crmorano/UWMD-NCSU/README.md

UWMD-NCSU
=========

Underwater Metal Detector Design
