crmorano/UWMD-NCSU/SchematicAndPCB/Readme.txt

Group 6, UnderWater Metal Detector
Chris Morano
Dorian Perry
Bryson Pender

UnderWaterMetalDetector_v2.brd - EAGLE Board File
UnderWaterMetalDetector_v2.sch - EAGLE Schematic File
UnderWaterMetalDetector_v2.pdf - PDF of Eagle Schematic File
UWMD-BuildBOM.xlsx - Build BOM
UWMD-SeniorDesign-SeeedGerbers.zip - Gerber Files for SeeedStudio's Fusion PCB Service
