crmorano/UWMD-NCSU/SchematicAndPCB/UWMD-BuildBOM.xlsx

Sheet: Sheet1
Installed | Part | Value | Device | Package | Description | TP_SIGNAL_NAME
 | C1 | 0.1u | C-USC1206 | C1206 | CAPACITOR, American symbol
 | C6 | 0.1u | C-USC1206 | C1206 | CAPACITOR, American symbol
 | C7 | 0.1u | C-USC1206 | C1206 | CAPACITOR, American symbol
 | C8 | 0.1u | C-USC1206 | C1206 | CAPACITOR, American symbol
 | C11 | 0.1u | C-USC1206 | C1206 | CAPACITOR, American symbol
 | C12 | 47n | C-USC1206 | C1206 | CAPACITOR, American symbol
 | C13 | 0.1u | C-USC1206 | C1206 | CAPACITOR, American symbol
 | C14 | 0.1u | C-USC1206 | C1206 | CAPACITOR, American symbol
 | C15 | 47u | C-USC1206 | C1206 | CAPACITOR, American symbol | Ugh
 | C16 | 1u | C-USC1206 | C1206 | CAPACITOR, American symbol | Changed from 10u
 | COIL | CON-SIP2-0.1 | CON-SIP2-0.1 | CON-SIP2-0.1
 | D1 | 1N5819-T | 1N5819-T | DO41-7.6 | 1.0A SCHOTTKY BARRIER RECTIFIER | Already Have
 | D2 | 1N5819-T | 1N5819-T | DO41-7.6 | 1.0A SCHOTTKY BARRIER RECTIFIER | Already Have
 | D3 | 1N4004 | 1N4004 | DO41-10 | DIODE
 | D4 | 1N4004 | 1N4004 | DO41-10 | DIODE
 | D5 | P6KE68CA | DIODE-D-5 | D-5 | DIODE | Already Have
 | D6 | 1N4004 | 1N4004 | DO41-10 | DIODE
 | D7 | 1N4004 | 1N4004 | DO41-10 | DIODE
 | DOWN | CON-SIP2-0.1 | CON-SIP2-0.1 | CON-SIP2-0.1
 | DZ1 | LB10 | LB10 | LB10 | LED BLOCK | Already Have
X | IC2 | MCP604SL | MCP604SL | SO14 | Quad Op Amp 2.7V to 6.0V Single Supply CMOS
X | IC4 | ULN2003AD | ULN2003AD | SO16 | DRIVER ARRAY
 | J1 |  | MTA08-100 | 10X08MTA | AMP connector | SIP header
 | J2 |  | MTA08-100 | 10X08MTA | AMP connector | SIP header
 | J3 |  | MTA10-100 | 10X10MTA | AMP connector | SIP header
 | J4 |  | MTA06-100 | 10X06MTA | AMP connector | SIP header
 | JP2 | OUT | M02PTH | 1X02 | Header 2 | SIP header
 | JP9 | IN | M02PTH | 1X02 | Header 2 | SIP header
 | JP12 | LiPoIN | M02PTH | 1X02 | Header 2 | SIP header
 | JP13 | M01PTH | M01PTH | 1X01 | Header 1 | SIP header
 | JP14 | M01PTH | M01PTH | 1X01 | Header 1 | SIP header
 | L2 | 100m | L-US0204V | 0204V | INDUCTOR, American symbol
 | LED1 | Red | LED5MM | LED5MM | LED
 | LED2 | Red | LED5MM | LED5MM | LED
 | MODE | CON-SIP2-0.1 | CON-SIP2-0.1 | CON-SIP2-0.1
 | MOTOR | CON-SIP2-0.1 | CON-SIP2-0.1 | CON-SIP2-0.1
 | Q1 | STGP18N40LZ | STGP18N40LZ | TO-220-HORIZ |  | Already Have
 | Q2 | FET-2N7000 | FET-2N7000 | TO92
 | R1 | 1K | R-US_M1206 | M1206 | RESISTOR, American symbol
 | R2 | 10K | R-US_R1206 | R1206 | RESISTOR, American symbol
 | R3 | 10K | R-US_R1206 | R1206 | RESISTOR, American symbol
 | R4 | 5K1 | R-US_R1206 | R1206 | RESISTOR, American symbol
 | R5 | 330R | R-US_M1206 | M1206 | RESISTOR, American symbol
 | R6 | 330R | R-US_M1206 | M1206 | RESISTOR, American symbol
 | R7 | 330R | R-US_M1206 | M1206 | RESISTOR, American symbol
 | R8 | 330R | R-US_M1206 | M1206 | RESISTOR, American symbol
 | R9 | 330R | R-US_M1206 | M1206 | RESISTOR, American symbol
 | R10 | 330R | R-US_M1206 | M1206 | RESISTOR, American symbol
 | R11 | 330R | R-US_M1206 | M1206 | RESISTOR, American symbol
 | R12 | 330R | R-US_M1206 | M1206 | RESISTOR, American symbol
 | R13 | 330R | R-US_M1206 | M1206 | RESISTOR, American symbol
 | R14 | 330R | R-US_M1206 | M1206 | RESISTOR, American symbol
 | R15 | 330R | R-US_M1206 | M1206 | RESISTOR, American symbol
 | R16 | 330R | R-US_M1206 | M1206 | RESISTOR, American symbol
 | R17 | 1K | R-US_M1206 | M1206 | RESISTOR, American symbol
 | R18 | 1K | R-US_M1206 | M1206 | RESISTOR, American symbol
 | R19 | 100R | R-US_R1206 | R1206 | RESISTOR, American symbol
 | R20 | 100K | R-US_M1206 | M1206 | RESISTOR, American symbol
 | R21 | 10R | R-US_R2512 | R2512 | RESISTOR, American symbol
 | R22 | 100K | R-US_R1206 | R1206 | RESISTOR, American symbol
 | R23 | 100R | R-US_R1206 | R1206 | RESISTOR, American symbol
 | R31 | 4k7 | R-US_R1206 | R1206 | RESISTOR, American symbol
 | R32 | 1K | R-US_M1206 | M1206 | RESISTOR, American symbol
 | R33 | 90K9 | R-US_M1206 | M1206 | RESISTOR, American symbol
 | R34 | 22K0 | R-US_M1206 | M1206 | RESISTOR, American symbol
 | R35 | 10K | R-US_R1206 | R1206 | RESISTOR, American symbol
 | R36 | 10K | R-US_M1206 | M1206 | RESISTOR, American symbol
 | R37 | 10K | R-US_M1206 | M1206 | RESISTOR, American symbol
 | R38 | 11K8?? | R-US_M1206 | M1206 | RESISTOR, American symbol
 | R39 | 10K | R-US_M1206 | M1206 | RESISTOR, American symbol
 | R40 | 10K | R-US_M1206 | M1206 | RESISTOR, American symbol
 | R42 | 8R 1W | R-US_R2512 | R2512 | RESISTOR, American symbol
 | SW_DOWN | SW-SCHURTER-1301.9306 | SW-SCHURTER-1301.9306 | SW-SCHURTER-1301.9306 |  | Already Have
 | SW_MODE | SW-SCHURTER-1301.9306 | SW-SCHURTER-1301.9306 | SW-SCHURTER-1301.9306 |  | Already Have
 | SW_POW | SW-TL2201EEYA | SW-TL2201EEYA | SW-TL2201EEYA
 | SW_UP | SW-SCHURTER-1301.9306 | SW-SCHURTER-1301.9306 | SW-SCHURTER-1301.9306 |  | Already Have
 | TP1 | TPSQPAD1-13 | TPSQPAD1-13 | P1-13 | Test pad | No-Pop
 | TP2 | TPSQPAD1-13 | TPSQPAD1-13 | P1-13 | Test pad | No-Pop
 | TP3 | TPSQPAD1-13 | TPSQPAD1-13 | P1-13 | Test pad | No-Pop
 | TP4 | TPSQPAD1-13 | TPSQPAD1-13 | P1-13 | Test pad | No-Pop
 | TP5 | TPSQPAD1-13 | TPSQPAD1-13 | P1-13 | Test pad | No-Pop
 | TP6 | TPSQPAD1-13 | TPSQPAD1-13 | P1-13 | Test pad | No-Pop
 | TP7 | TPSQPAD1-13 | TPSQPAD1-13 | P1-13 | Test pad | No-Pop
 | TP8 | TPSQPAD1-13 | TPSQPAD1-13 | P1-13 | Test pad | No-Pop
 | TP9 | TPSQPAD1-13 | TPSQPAD1-13 | P1-13 | Test pad | No-Pop
 | TP10 | TPSQPAD1-13 | TPSQPAD1-13 | P1-13 | Test pad | No-Pop
 | U$3 | OSHW-LOGOS | OSHW-LOGOS | OSHW-LOGO-S | Open Source Hardware Logo This logo indicates the piece of hardware it is found on incorporates a OSHW license and/or adheres to the definition of open source hardware found here: http://freedomdefined.org/OSHW
 | U$4 | CREATIVE_COMMONS | CREATIVE_COMMONS | CREATIVE_COMMONS | Creative Commons License summary
 | UP | CON-SIP2-0.1 | CON-SIP2-0.1 | CON-SIP2-0.1

Sheet: Sheet2
Qty | Part | Value | Device | Package | Description | Notes | MFG | MFG Part Number | Digikey Part Number | Price at qty to build 5
7 | C1, C6, C7, C8, C11, C13, C14 | 0.1u | C-USC1206 | C1206 | CAP CER 0.1UF 50V 5% NP0 1206 |  | TDK | CGA5L2C0G1H104J160AA | 445-6984-1-ND | 0.67 | 4.69
1 | C12 | 47n | C-USC1206 | C1206 | CAP CER 0.047UF 50V 5% NP0 1206 |  | TDK | CGA5H2C0G1H473J115AA | 445-6982-1-ND | 0.6 | 0.6
1 | C15 | 47u | C-USC1206 | C1206 | CAP TANT 47UF 10V 20% 1206 |  | Rohm | TCTAL1A476M8R | 511-1500-1-ND | 1.19 | 1.19
1 | C16 | 1u | C-USC1206 | C1206 | CAP CER 1UF 100V 10% X7R 1206 |  | Taiyo Yuden | HMK316B7105KL-T | 587-1777-1-ND | 0.38 | 0.38
5 | COIL, UP, DOWN, MODE, MOTOR | CON-SIP2-0.1 | CON-SIP2-0.1 | CON-SIP2-0.1 | CONN TERM BLOCK 2.54MM 2POS PCB |  | On Shore | OSTVN02A150 | ED10561-ND | 0.51 | 2.55
2 | D1, D2, D7 | 1N5819-T | 1N5819-T | DO41-7.6 | 1.0A SCHOTTKY BARRIER RECTIFIER |  | Diodes Inc | 1N5819-T | 1N5819DICT-ND | 0.315 | 0.63
4 | D3, D4, D6 | 1N4004 | 1N4004 | DO41-10 | DIODE GEN PURPOSE 400V 1A DO41 |  | Diodes Inc | 1N4004-T | 1N4004DICT-ND | 0.12 | 0.48
1 | D5 | P6KE68CA | DIODE-D-5 | D-5 | TVS 68 VOLT 600 WATT BI-DIR | Install upright | Littelfuse | P6KE68CA | P6KE68CALFCT-ND | 0.49 | 0.49
1 | DZ1 | LB10 | LB10 | LB10 | LED BLOCK |  | Lite-On | LTA-1000HR | 160-1066-ND | 1.26 | 1.26
1 | IC2 | MCP604SL | MCP6004 | SO14 | Quad Op Amp 2.7V to 6.0V Single Supply CMOS |  | Microchip | MCP6004-I/SL | MCP6004-I/SL-ND | 0.53 | 0.53
1 | IC4 | ULN2003AD | ULN2003AD | SO16 | DRIVER ARRAY |  | TI | ULN2003AIDR | 296-15407-1-ND | 0.65 | 0.65
2 | J1, J2, J3, J4, JP13, JP14, JP2, JP9, JP12 |  | MTA08-100 | 10X08MTA | 0.1" Spacing Break Away Pins | JP12 No pop |  |  | SAM1112-20-ND | 2.302 | 4.604
1 | L2 | 100m | L-US0204V | 0204V | INDUCTOR, American symbol |  | EPCOS | B82144A2107J | 495-5616-1-ND | 1.08 | 1.08
2 | LED1, LED2 | Red | LED5MM | LED5MM | LED |  | Cree | C4SMF-RJS-CT0W0BB2 | C4SMF-RJS-CT0W0BB2CT-ND | 0.2 | 0.4
1 | Q1 | STGP18N40LZ | STGP18N40LZ | TO-220-HORIZ | IGBT 420V 30A 150W TO220 |  | ST Micro | STGP18N40LZ | 497-12597-5-ND | 1.55 | 1.55
1 | Q2 | FET-2N7000 | FET-2N7000 | TO92 | MOSFET N-CHAN 60V TO92-3 |  | Diodes Inc | ZVN4206AVSTZ | ZVN4206AVSCT-ND | 0.78 | 0.78
4 | R1, R17, R18, R32 | 1K | R-US_M1206 | M1206 | RES 1K OHM 1/4W 1% 1206 |  | Stackpole | RMCF1206FT1K00 | RMCF1206FT1K00CT-ND | 0.044 | 0.176
2 | R19, R23 | 100R | R-US_R1206 | R1206 | RES 100 OHM 1/4W 1% 1206 |  | Stackpole | RMCF1206FT100R | RMCF1206FT1K00CT-ND | 0.06 | 0.12
6 | R3, R35, R36, R37, R39, R40 | 10K | R-US_R1206 | R1206 | RES 10K OHM 1/4W 1% 1206 |  | Stackpole | RMCF1206FT10K0 | RMCF1206FT10K0CT-ND | 0.044 | 0.264
2 | R20, R22 | 100K | R-US_M1206 | M1206 | RES 100K OHM 1/4W 1% 1206 |  | Stackpole | RMCF1206FT100K | RMCF1206FT100KCT-ND | 0.06 | 0.12
1 | R21 | 10R | R-US_R2512 | R2512 | RES 10 OHM 1W 1% 2512 |  | Stackpole | RMCF2512JT10R0 | RMCF2512JT10R0CT-ND | 0.44 | 0.44
1 | R31 | 4k7 | R-US_R1206 | R1206 | RES 4K75 OHM 1/4W 1% 1206 |  | Stackpole | RMCF1206FT4K75 | RMCF1206FT4K75CT-ND | 0.06 | 0.06
1 | R33 | 90K9 | R-US_M1206 | M1206 | RES 90K9 OHM 1/4W 1% 1206 |  | Stackpole | RMCF1206FT90K9 | RMCF1206FT90K9CT-ND | 0.06 | 0.06
1 | R34 | 22K0 | R-US_M1206 | M1206 | RES 22K1 OHM 1/4W 1% 1206 |  | Stackpole | RMCF1206FT22K1 | RMCF1206FT22K1CT-ND | 0.06 | 0.06
1 | R38 | 10k5 | R-US_M1206 | M1206 | RES 10K7 OHM 1/4W 1% 1206 |  | Stackpole | RMCF1206FT10K5 | RMCF1206FT10K5CT-ND | 0.06 | 0.06
1 | R4 | 5K1 | R-US_R1206 | R1206 | RES 5K11 OHM 1/4W 1% 1206 |  | Stackpole | RMCF1206FT5K11 | RMCF1206FT5K11CT-ND | 0.06 | 0.06
1 | R42 | 7R5 1W | R-US_R2512 | R2512 | RES 7R50 OHM 1 1% 2512 |  | Stackpole | RMCF2512JT7R50 | RMCF2512JT7R50CT-ND | 0.44 | 0.44
14 | R2, R5, R6, R7, R8, R9, R10, R11, R12, R13, R14, R15, R16, R24 | 511R | R-US_M1206 | M1206 | RES 511 OHM 1/4W 1% 1206 |  | Stackpole | RMCF1206FT511R | RMCF1206FT511RCT-ND | 0.0242 | 0.3388
3 | SW_DOWN, SW_MODE, SW_UP |  | PUSHBUTTON | PUSHBUTTON |  |  | TE | FSM4JH | 450-1650-ND | 0.092 | 0.276
1 | SW_POW | SW-TL2201EEYA | SW-TL2201EEYA | SW-TL2201EEYA |  |  | E-Switch | TL2201EEYA | TL2201EEYA-ND | 0.66 | 0.66
1 |  |  | Motor |  |  | Not On Board | Parallax | 28822 | 28822-ND | 4.99 | 4.99
1 |  |  | Power |  | SFE LiPo Boost Charger Circuit | Not On Board | Sparkfun | PRT-11231 |  | 19.95 | 19.95
1 |  |  | Battery |  | 850mAh LiPo 3.7V Battery | Not On Board | Sparkfun | PRT-00341 |  | 8.95 | 8.95
1 |  |  | Arduino |  | Sparkfun Redboard Arduino Uno | Not On Board | Sparkfun | DEV-11575 |  | 24.95 | 24.95
1 |  |  | PCB |  | PCB Assembly Service | Not On Board | Fusion PCB |  |  | 6 | 6
1 |  |  | Wire |  |  | Not On Board | Radioshack | 278-1345
 |  |  |  |  |  |  |  |  |  |  | 89.8388
