crmorano/UWMD-NCSU/SchematicAndPCB/UnderWaterMetalDetector_v2.pdf

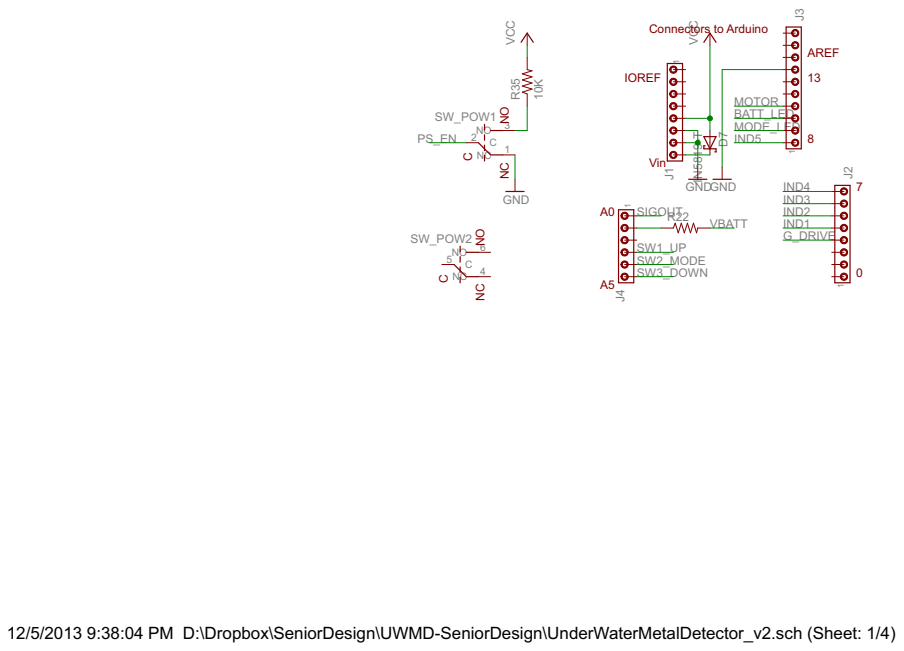
[picture p1: page 1]

12/5/2013 9:38:04 PM D:\Dropbox\SeniorDesign\UWMD-SeniorDesign\UnderWaterMetalDetector_v2.sch (Sheet: 1/4)

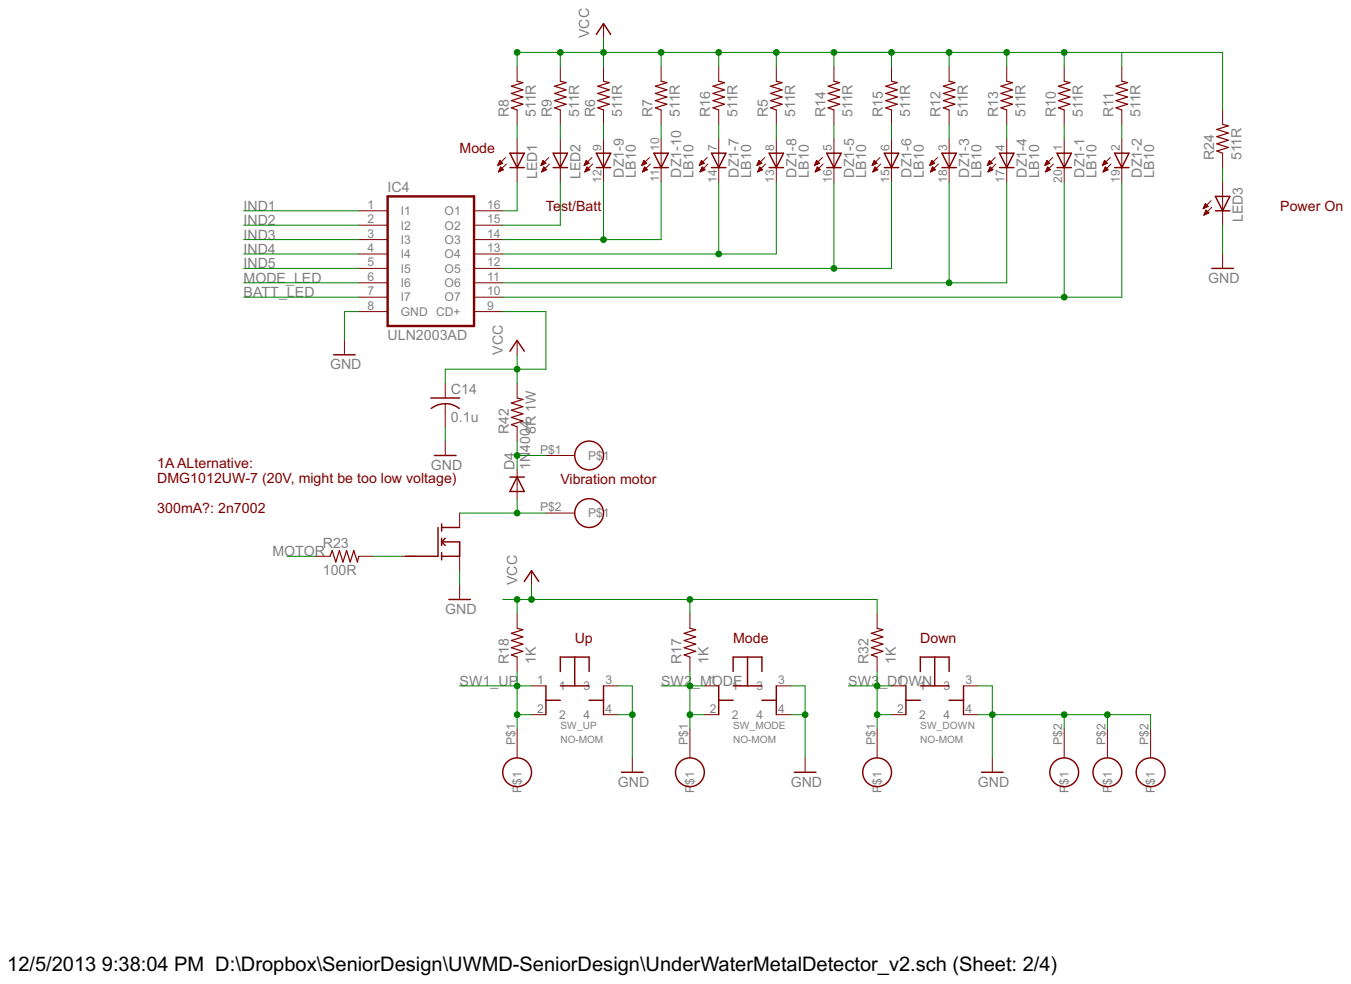
[picture p2: page 2]

1A ALternative: DMG1012UW-7 (20V, might be too low voltage)

12/5/2013 9:38:04 PM D:\Dropbox\SeniorDesign\UWMD-SeniorDesign\UnderWaterMetalDetector_v2.sch (Sheet: 2/4)

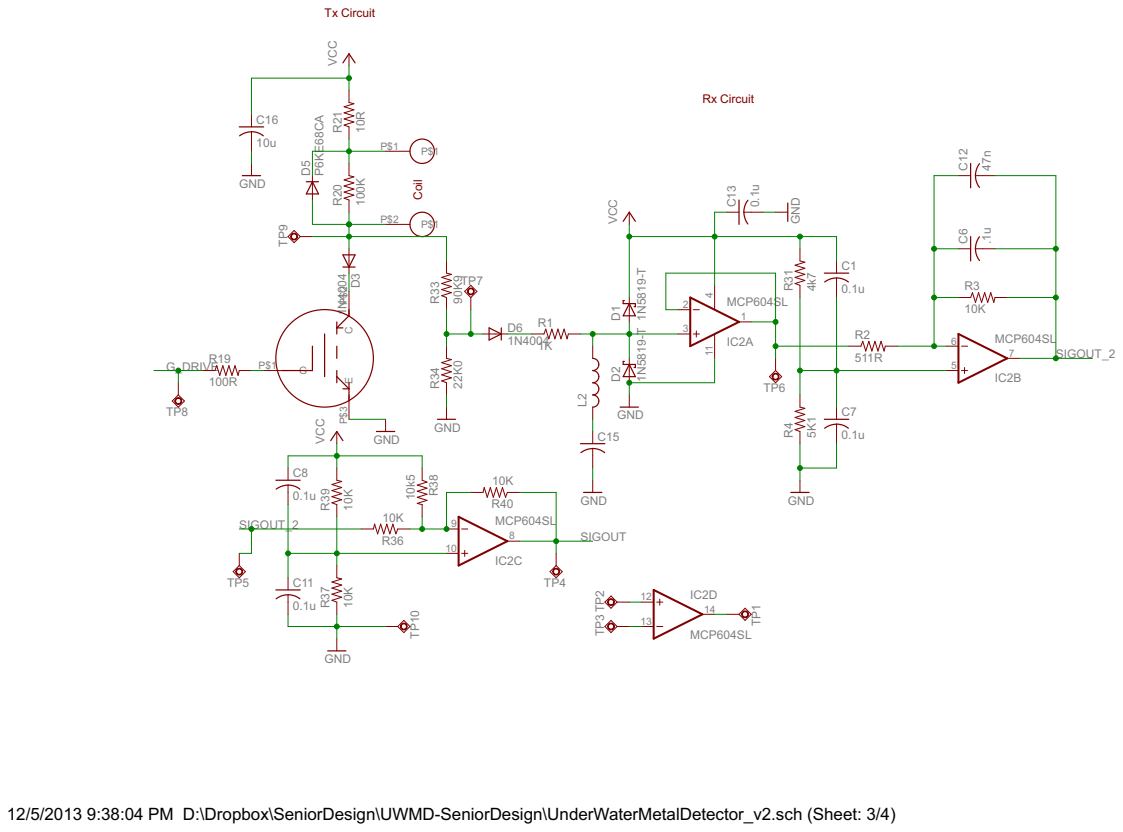
[picture p3: page 3]

12/5/2013 9:38:04 PM D:\Dropbox\SeniorDesign\UWMD-SeniorDesign\UnderWaterMetalDetector_v2.sch (Sheet: 3/4)

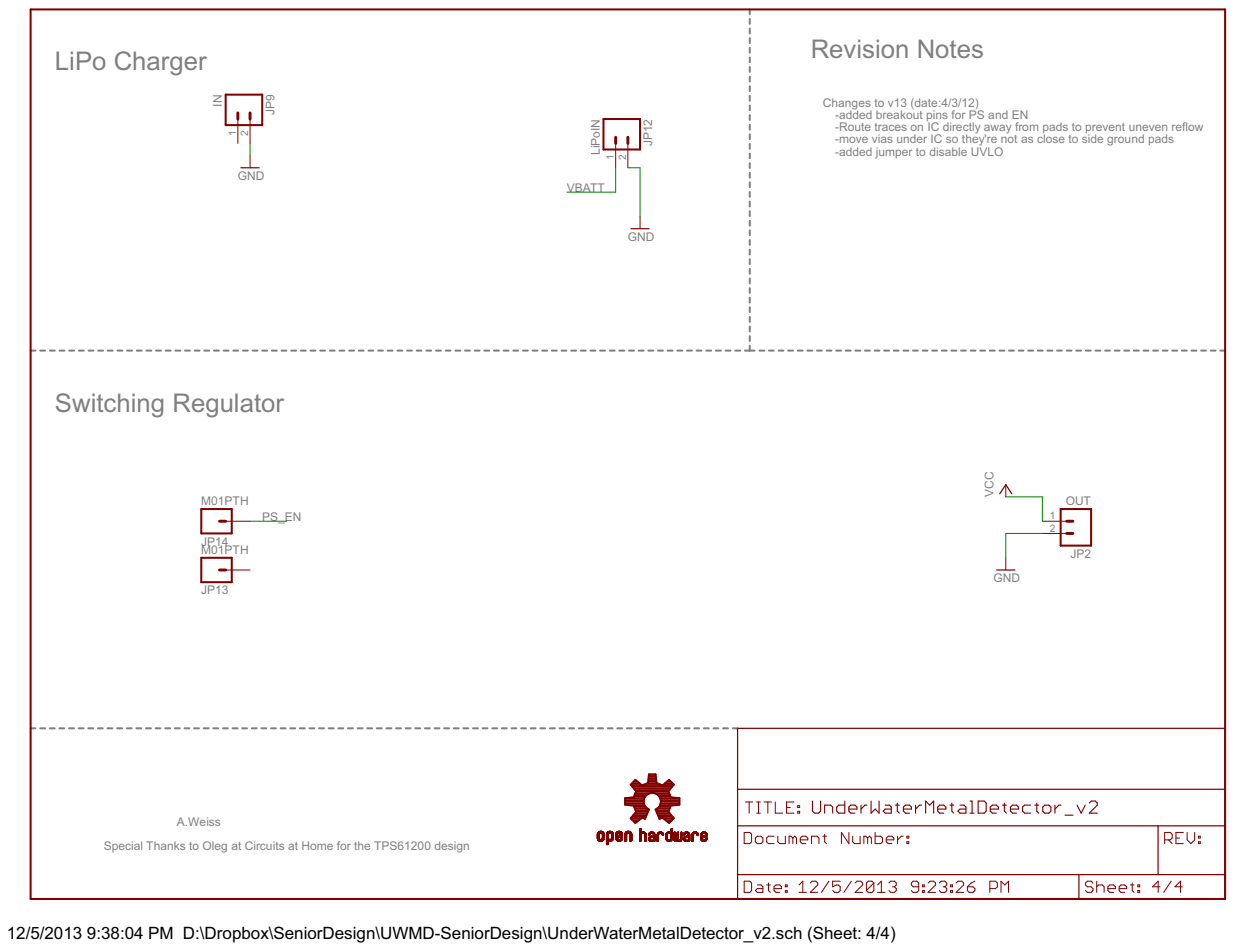
[picture p4: page 4]

Changes to v13 (date:4/3/12)
-added breakout pins for PS and EN
-Route traces on IC directly away from pads to prevent uneven reflow
-move vias under IC so they're not as close to side ground pads
-added jumper to disable UVLO

A.Weiss Special Thanks to Oleg at Circuits at Home for the TPS61200 design

12/5/2013 9:38:04 PM D:\Dropbox\SeniorDesign\UWMD-SeniorDesign\UnderWaterMetalDetector_v2.sch (Sheet: 4/4)
