crmorano/UWMD-NCSU/SchematicAndPCB/UnderWaterMetalDetector_v2.brd

## EAGLE design SchematicAndPCB/UnderWaterMetalDetector_v2.brd (2013-12-06)

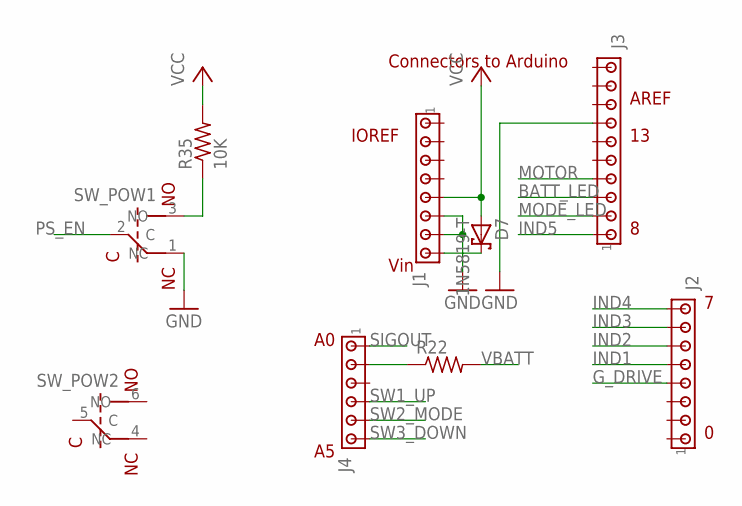
[picture p5: schematic UnderWaterMetalDetector_v2.sch, sheet 1]

Parts:
D7: 1N5819-T; DO41-7.6
J1, J2: MTA08-100; 10X08MTA
J3: MTA10-100; 10X10MTA
J4: MTA06-100; 10X06MTA
R22: R-US_R1206; R1206
R35: 10K; R1206
SW_POW: SW-TL2201EEYA

Connections:
BATT_LED: J3.3; also elsewhere on the board
GND: J1.6, J1.7, J3.7, SW_POW.1 (NC); also elsewhere on the board
G_DRIVE: J2.4; also elsewhere on the board
IND1: J2.5; also elsewhere on the board
IND2: J2.6; also elsewhere on the board
IND3: J2.7; also elsewhere on the board
IND4: J2.8; also elsewhere on the board
IND5: J3.1; also elsewhere on the board
MODE_LED: J3.2; also elsewhere on the board
MOTOR: J3.4; also elsewhere on the board
unnamed: J4.5 (2), R22.1
unnamed: D7.C, J1.8
unnamed: R35.1, SW_POW.3 (NO)
PS_EN: SW_POW.2 (C); also elsewhere on the board
SIGOUT: J4.6 (1); also elsewhere on the board
SW1_UP: J4.3 (4); also elsewhere on the board
SW2_MODE: J4.2 (5); also elsewhere on the board
SW3_DOWN: J4.1 (6); also elsewhere on the board
VBATT: R22.2; also elsewhere on the board
VCC: D7.A, J1.5, R35.2; also elsewhere on the board

Notes on the sheet:
Vin
IOREF
AREF
Connectors to Arduino

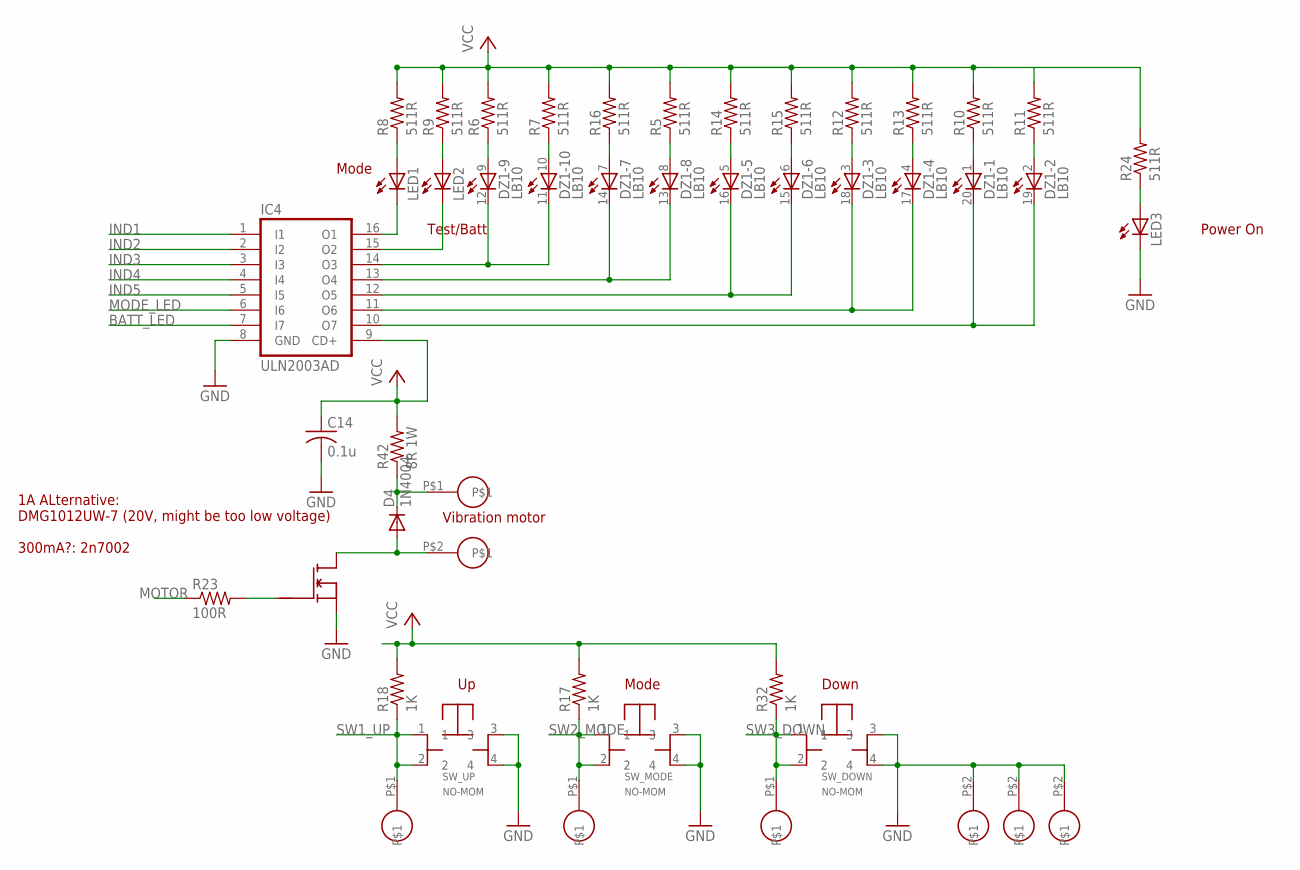
[picture p6: schematic UnderWaterMetalDetector_v2.sch, sheet 2, User Interface]

Parts:
C14: 0.1u; C1206
D4: 1N4004; DO41-10
DOWN: CON-SIP2-0.1
DZ1: LB10
IC4: ULN2003AD; SO16
LED1, LED2, LED3: LED5MM
MODE: CON-SIP2-0.1
MOTOR: CON-SIP2-0.1
Q2: FET-2N7000; TO92
R5, R6, R7, R8, R9, R10, R11, R12, R13, R14, R15, R16, R24: 511R; M1206
R17, R18, R32: 1K; M1206
R23: 100R; R1206
R42: 8R 1W; R2512
SW_DOWN: SW-SCHURTER-1301.9306
SW_MODE: SW-SCHURTER-1301.9306
SW_UP: SW-SCHURTER-1301.9306
UP: CON-SIP2-0.1

Connections:
BATT_LED: IC4.7 (I7); also elsewhere on the board
GND: C14.2, DOWN.P$2, IC4.8 (GND), LED3.K (C), MODE.P$2, Q2.1 (S), SW_DOWN.3, SW_DOWN.4, SW_MODE.3, SW_MODE.4, SW_UP.3, SW_UP.4, UP.P$2; also elsewhere on the board
IND1: IC4.1 (I1); also elsewhere on the board
IND2: IC4.2 (I2); also elsewhere on the board
IND3: IC4.3 (I3); also elsewhere on the board
IND4: IC4.4 (I4); also elsewhere on the board
IND5: IC4.5 (I5); also elsewhere on the board
MODE_LED: IC4.6 (I6); also elsewhere on the board
MOTOR: R23.1; also elsewhere on the board
unnamed: D4.C, MOTOR.P$1, R42.1
unnamed: DZ1.17 (C), DZ1.18 (C), IC4.11 (O6)
unnamed: Q2.2 (G), R23.2
unnamed: LED3.A, R24.1
unnamed: DZ1.19 (C), DZ1.20 (C), IC4.10 (O7)
unnamed: DZ1.15 (C), DZ1.16 (C), IC4.12 (O5)
unnamed: DZ1.13 (C), DZ1.14 (C), IC4.13 (O4)
unnamed: DZ1.11 (C), DZ1.12 (C), IC4.14 (O3)
unnamed: IC4.16 (O1), LED1.K (C)
unnamed: IC4.15 (O2), LED2.K (C)
unnamed: LED2.A, R9.1
unnamed: LED1.A, R8.1
unnamed: DZ1.10 (A), R7.1
unnamed: DZ1.9 (A), R6.1
unnamed: DZ1.8 (A), R5.1
unnamed: DZ1.1 (A), R10.1
unnamed: DZ1.2 (A), R11.1
unnamed: DZ1.3 (A), R12.1
unnamed: DZ1.4 (A), R13.1
unnamed: DZ1.5 (A), R14.1
unnamed: DZ1.6 (A), R15.1
unnamed: DZ1.7 (A), R16.1
unnamed: D4.A, MOTOR.P$2, Q2.3 (D)
SW1_UP: R18.1, SW_UP.1, SW_UP.2, UP.P$1; also elsewhere on the board
SW2_MODE: MODE.P$1, R17.1, SW_MODE.1, SW_MODE.2; also elsewhere on the board
SW3_DOWN: DOWN.P$1, R32.1, SW_DOWN.1, SW_DOWN.2; also elsewhere on the board
VCC: C14.1, IC4.9 (CD+), R5.2, R6.2, R7.2, R8.2, R9.2, R10.2, R11.2, R12.2, R13.2, R14.2, R15.2, R16.2, R17.2, R18.2, R24.2, R32.2, R42.2; also elsewhere on the board

Notes on the sheet:
Vibration motor
Mode
Test/Batt
Down
1A ALternative: DMG1012UW-7 (20V, might be too low voltage) 300mA?: 2n7002
Power On

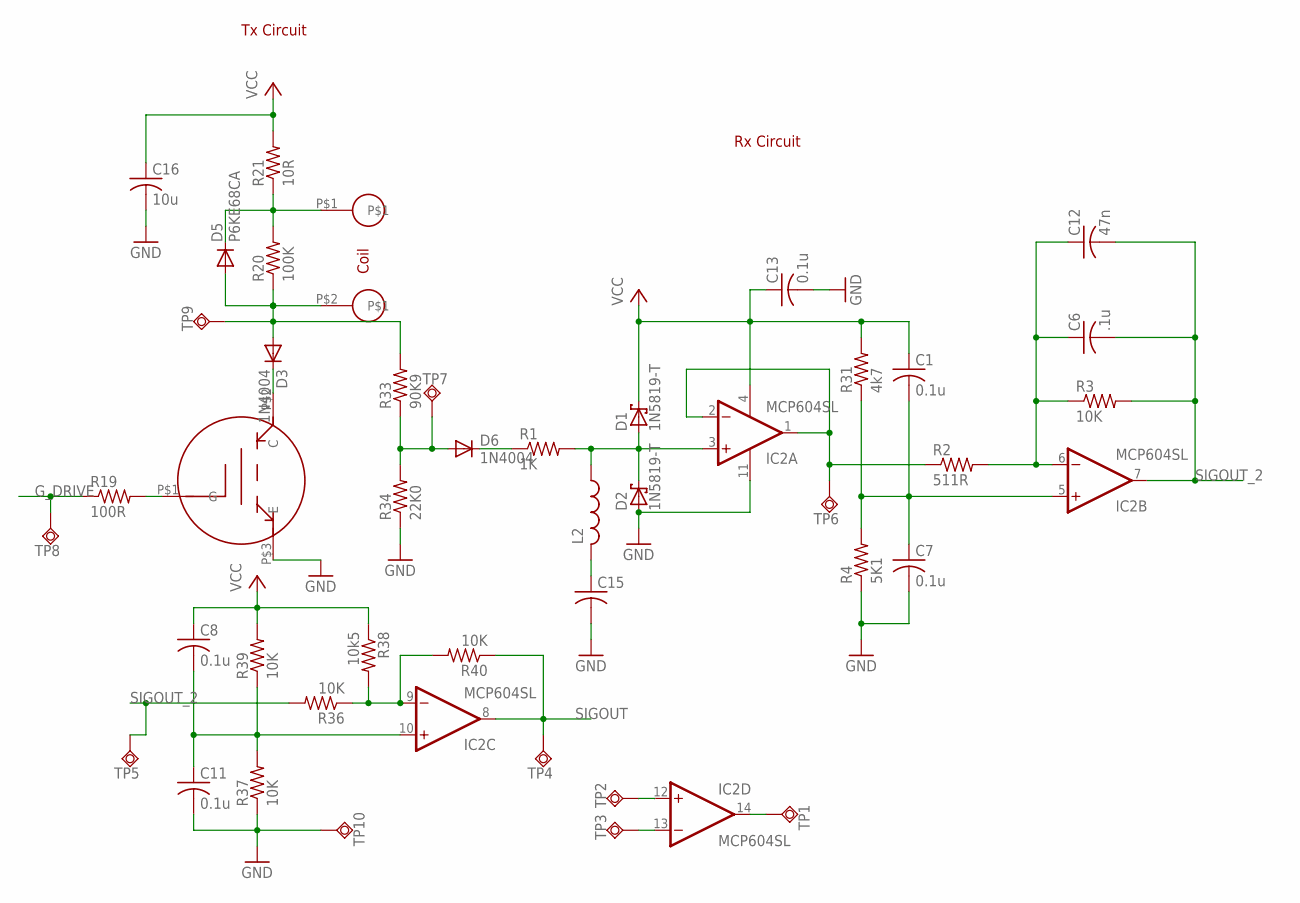
[picture p7: schematic UnderWaterMetalDetector_v2.sch, sheet 3]

Parts:
C1, C7, C8, C11, C13: 0.1u; C1206
C6: .1u; C1206
C12: 47n; C1206
C15: C-USC1206; C1206
C16: 10u; C1206
COIL: CON-SIP2-0.1
D1, D2: 1N5819-T; DO41-7.6
D3, D6: 1N4004; DO41-10
D5: P6KE68CA; D-5
IC2: MCP604SL; SO14
L2: L-US0204V; 0204V
Q1: STGP18N40LZ; TO-220-HORIZ
R1: 1K; M1206
R2: 511R; R1206
R3: 10K; R1206
R4: 5K1; R1206
R19: 100R; R1206
R20: 100K; M1206
R21: 10R; R2512
R31: 4k7; R1206
R33: 90K9; M1206
R34: 22K0; M1206
R36, R37, R39, R40: 10K; M1206
R38: 10k5; M1206
TP1, TP2, TP3, TP4, TP5, TP6, TP7, TP8, TP9, TP10: TPSQPAD1-13; P1-13

Connections:
GND: C7.2, C11.2, C13.2, C15.2, C16.2, D2.A, IC2.11 (V-), Q1.P$3 (E), R4.1, R34.1, R37.1, TP10.TP; also elsewhere on the board
G_DRIVE: R19.1, TP8.TP; also elsewhere on the board
unnamed: IC2.1 (OUT), IC2.2 (-IN), R2.1, TP6.TP
unnamed: D1.A, D2.C, IC2.3 (+IN), L2.1, R1.2
unnamed: D6.C, R1.1
unnamed: C1.2, C7.1, IC2.5 (+IN), R4.2, R31.1
unnamed: C8.2, C11.1, IC2.10 (+IN), R37.2, R39.1
unnamed: D6.A, R33.1, R34.2, TP7.TP
unnamed: C6.1, C12.1, IC2.6 (-IN), R2.2, R3.1
unnamed: IC2.9 (-IN), R36.1, R38.2, R40.2
unnamed: IC2.12 (+IN), TP2.TP
unnamed: IC2.13 (-IN), TP3.TP
unnamed: IC2.14 (OUT), TP1.TP
unnamed: C15.1, L2.2
unnamed: COIL.P$1, D5.C, R20.2, R21.1
unnamed: D3.C, Q1.P$2 (C)
unnamed: Q1.P$1 (G), R19.2
RXIN: COIL.P$2, D3.A, D5.A, R20.1, R33.2, TP9.TP
SIGOUT: IC2.8 (OUT), R40.1, TP4.TP; also elsewhere on the board
SIGOUT_2: C6.2, C12.2, IC2.7 (OUT), R3.2, R36.2, TP5.TP
VCC: C1.1, C8.1, C13.1, C16.1, D1.C, IC2.4 (V+), R21.2, R31.2, R38.1, R39.2; also elsewhere on the board

Notes on the sheet:
Coil
Tx Circuit
Rx Circuit

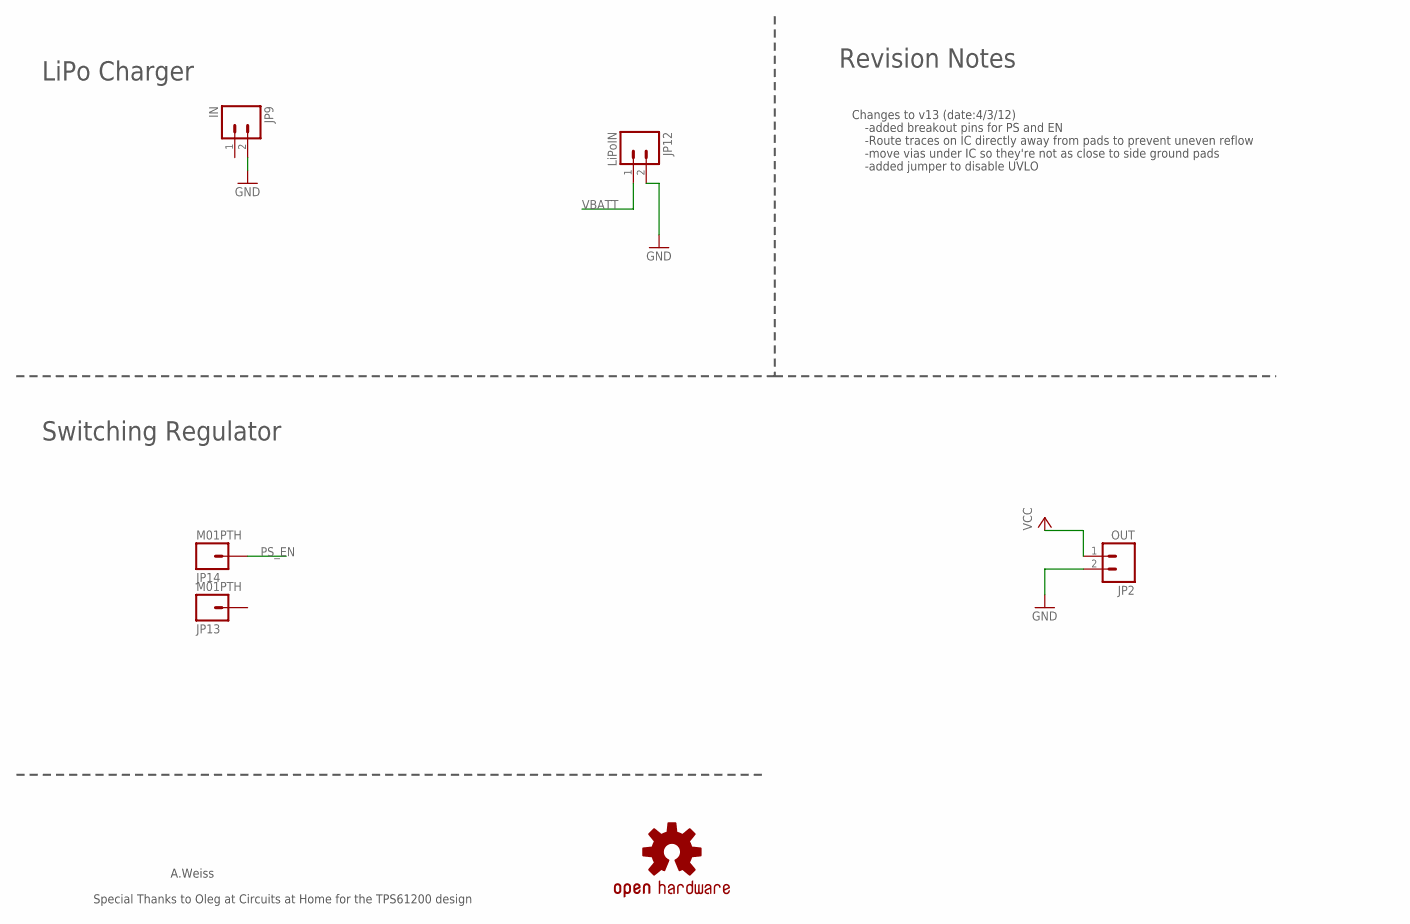
[picture p8: schematic UnderWaterMetalDetector_v2.sch, sheet 4]

Parts:
JP2: OUT; 1X02
JP9: IN; 1X02
JP12: LiPoIN; 1X02
JP13, JP14: M01PTH; 1X01
U$3: OSHW-LOGOS; OSHW-LOGO-S

Connections:
GND: JP2.2, JP9.2, JP12.2; also elsewhere on the board
PS_EN: JP14.1; also elsewhere on the board
VBATT: JP12.1; also elsewhere on the board
VCC: JP2.1; also elsewhere on the board

Notes on the sheet:
Changes to v13 (date:4/3/12)
-added breakout pins for PS and EN
-Route traces on IC directly away from pads to prevent uneven reflow
-move vias under IC so they're not as close to side ground pads
-added jumper to disable UVLO
A.Weiss
Special Thanks to Oleg at Circuits at Home for the TPS61200 design
LiPo Charger
Switching Regulator
Revision Notes

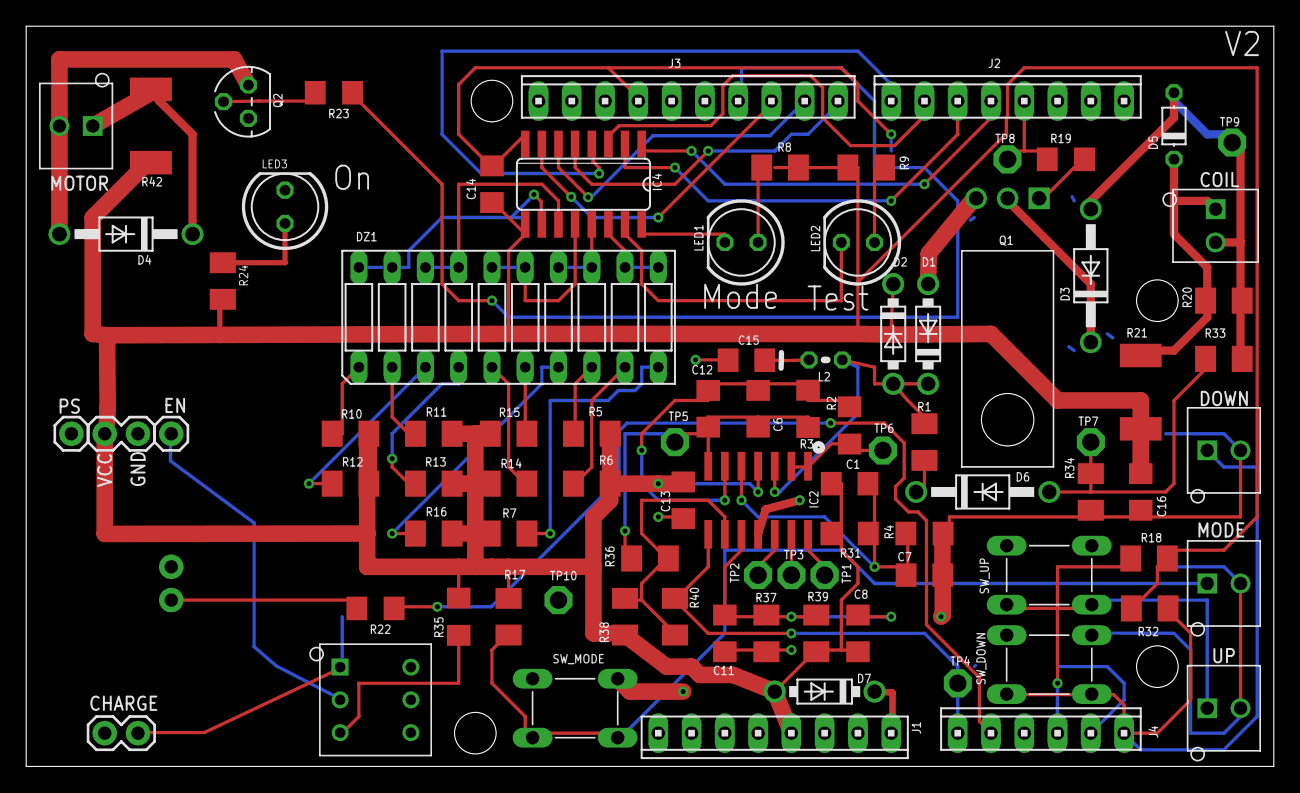
[picture p9: board UnderWaterMetalDetector_v2.brd from above]

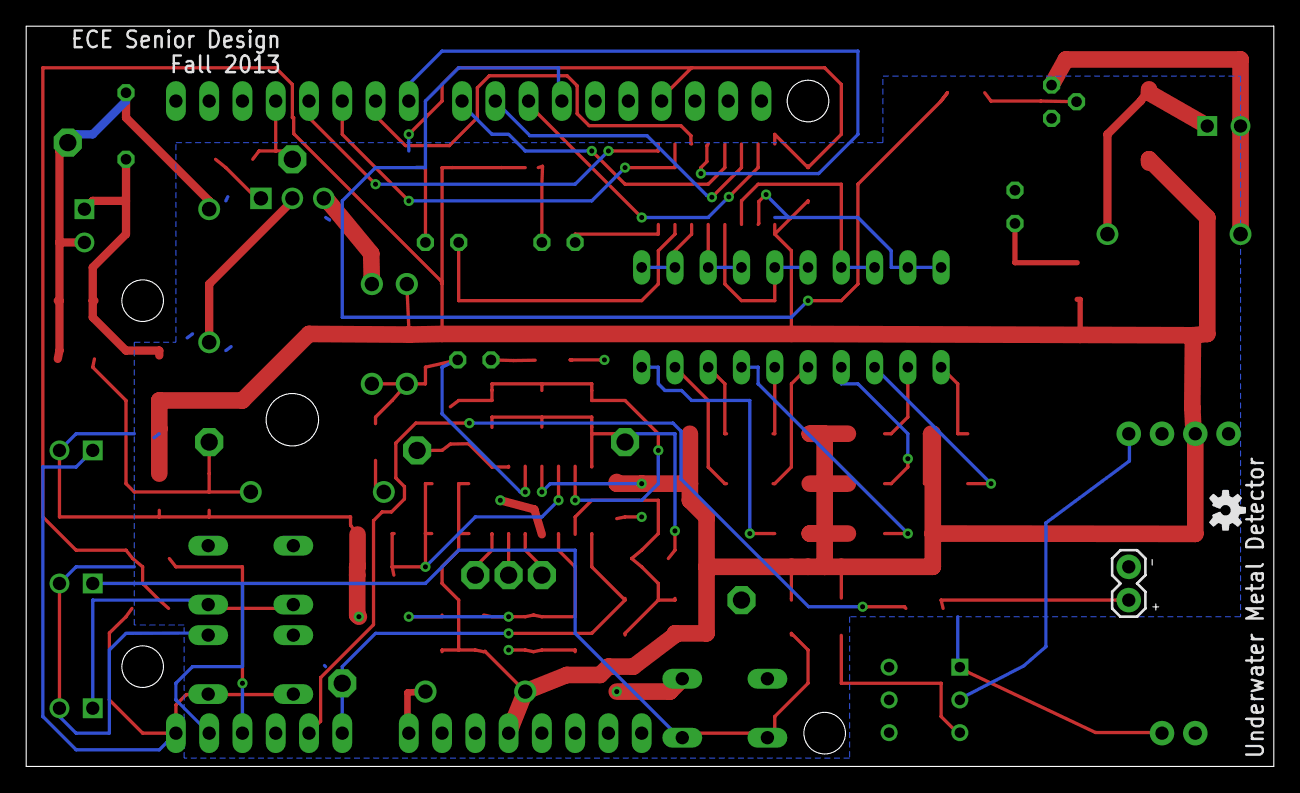
[picture p10: board UnderWaterMetalDetector_v2.brd from below]

Board: 2 copper layers, 95.2 x 56.5 mm, 90 parts (2 on the bottom side), 60 nets.
