crmorano/UWMD-NCSU/(commit log)

2013-11-25 Adding Code Files for Arduino Uno R3
    UWMD_final_software.ino most recent, includes a test file
    SeniorDesign_Software.ino
2013-12-06 Updated for Final Design
    Added the PCB, Added Schematic, Added BOM, Code now works properly and
    with the motor.
    [UWMD-BuildBOM.xlsx, UnderWaterMetalDetector_v2.brd, UnderWaterMetalDetector_v2.sch]
2013-12-06 Updates
    Added Readme, updated Build BOM to include Wire, Added SeeedStudio
    Gerbers.
    [UWMD-BuildBOM.xlsx]
